sinara-hw/BaseMod/README.md

# BaseMod
Sayma RTM basic AFE module with RF output

## Design Files

Design files (schematics, PCB layouts, BOMs) can be found at [BaseMod/Releases](https://github.com/sinara-hw/BaseMod/releases).

## Wiki

More information can be found on the [wiki](https://github.com/sinara-hw/BaseMod/wiki).
