sinara-hw/BaseMod/(list of files, drawings)

Other design files:
ADC_4CH.SchDoc
BaseMod.PrjPCB
BaseMod.SchDoc
DAC_channel.SchDoc
Input_channel.SchDoc
Mgmt.SchDoc
PowerSupply.SchDoc
SEAx_connector.SchDoc
