sinara-hw/BaseMod/(threads)

Thread 1 (2018-08-18):

baseMod documentation

gkasprow, 2018-08-18:
_From @jbqubit on January 26, 2018 20:9_

baseMod is the-board-formerly-known-as-Allaki.

### AFE Interface

Discuss broader AFE interface concept. baseMod is one manifestation of an analog front end.

### baseMod details
[Wiki](https://github.com/m-labs/sinara/wiki/SaymaAFE) gives a head start.
- [ ] discussion of use case (frequency range, output impedance, etc)
- [ ] AFE interface (photo, names of pins)
- [ ] power dissipated

### test results
- [ ] output chain phase noise
- [ ] switch isolation
- [ ] attenuator isolation
- [ ] power supply rejection
- [ ] AM noise
- [ ] switch settling time
- [ ] attenuator settling time
- frequency-dependent plots (10MHz - 4GHz)
    - [ ] output chain S parameters vs frequency
    - [ ] cross-talk vs frequency
    - [ ] IIP3 vs power and frequency (2D)

_Copied from original issue: sinara-hw/sinara#491_

gkasprow, 2018-08-18:
_From @jbqubit on February 7, 2018 5:1_

@filipswit can @sbouhabib help you with this section of documentation?

gkasprow, 2018-08-18:
_From @filipswit on February 8, 2018 22:15_

Yes sure, that would be great.

gkasprow, 2018-08-18:
_From @jbqubit on February 14, 2018 23:57_

@sbouhabib @gkasprow @filipswit any word on this?

Thread 2 (2018-08-18):

BaseMod remove power detector in next revision?

gkasprow, 2018-08-18:
_From @jbqubit on December 4, 2017 21:26_

- [ ] Consider removing power detector from Allaki

Context:
- Usefulness of power detector is unclear:
  - It only connects to 24-bit ADC, which is very slow and software/gateware support not funded yet.
  - Gain flatness of Sayma/BaseMod should be fairly good compared with the amplifiers, filters etc that are used after it. Thus one generally wants to do power-levelling at the point of load, not at Sayma RF connector
  - BaseMod will have a low-noise MSPS ADC with programmable-gain front-end. Users can place a small power detector near their load. e.g. ADL5511. This will allow closed-loop feedback to the RF at the point where the user cares. Moreover, thermal environment of external power detector can be better controlled, allowing improved stability. External power detector can potentially also be used for using feedback to remove thermal transients in amplifiers etc.
- Power detector is the biggest component on BaseMod. BaseMod is very cramped, removing this will help quite a bit. It also reduces the amount of software support needed for BaseMod (and the number of things that need production testing).

Risk:
- Low, just remove a component!

---

Moving from https://github.com/m-labs/sinara/issues/269.

@hartytp asks
> Does anyone object to removing the power detector from BaseMod v1.1? cf #397

@dhslichter responds
> The point of the power detector is to noise-eat at the output of the DACs. What is it costing us?

@hartytp responds

Yes, but only when the switch is off, and only via the 24-bit ADC.

Main cost is space: as @sbouhabib pointed out elsewhere, this is the largest component on BaseMod and fitting it on was actually quite challenging. If we remove it then we can make the layout a bit less tight.

Not a huge deal, but it's not totally cost free so unless you really plan to use it then we should scrap it.
-----------------

My comments....

Agreed that space occupied by the power detector design is huge. Especially because it involves impedance controlled traces. Design complexity due to the inclusion of the detector can only be described as very high.

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

It also consists of 27 BOM items. AD8363 is about $7/ea and HMC349 switch is about $5. Component cost is not high.

> I don't think it's actually that useful because:
> It is read out by the 24-bit ADC which is very slow

The original intent to compensate for long-term drift. Not for fast feedback. As you point out the power can only be monitored when the RF output to the physics target is off (using HMC349 switch). This was never intended for fast feedback.

Agreed that this is something that probably should have been culled from the original design.

_Copied from original issue: sinara-hw/sinara#411_

gkasprow, 2018-08-18:
_From @hartytp on December 4, 2017 21:27_

So, are we happy removing it then? Is that a decision or a discussion?

gkasprow, 2018-08-18:
_From @jbqubit on December 4, 2017 21:29_

@hartytp No. This is not a decision. This is moving the discussion to a separate thread for discussion.

gkasprow, 2018-08-18:
_From @hartytp on December 4, 2017 21:31_

optimistic ;)

gkasprow, 2018-08-18:
_From @jbqubit on December 4, 2017 21:31_

Let's add to errata list #269 only once a decision is made.

gkasprow, 2018-08-18:
_From @hartytp on December 4, 2017 21:32_

ack

gkasprow, 2018-08-18:
_From @dhslichter on December 4, 2017 21:34_

I don't love it enough to fight for it.

gkasprow, 2018-08-18:
_From @hartytp on December 4, 2017 21:36_

> I don't love it enough to fight for it.

IME, that's generally a good indication that it's not useful enough to be worth keeping. I'll keep the pistols ready in case you change your mind though ;)

gkasprow, 2018-08-18:
_From @dhslichter on December 4, 2017 21:38_

I think my rationale is that probably I will be rolling my own special-purpose AFEs for the applications we want to be ultra-precise on and so we can always go back to this if we want to use it for design ideas later.

gkasprow, 2018-08-18:
_From @hartytp on December 4, 2017 21:40_

Sounds good. Let's get a stripped down basic AFE that works really nicely. People can then add their own pet features to it as they desire.

gkasprow, 2018-08-18:
_From @dtcallcock on December 4, 2017 21:41_

The two large red areas @jbqubit highlights on the left of the top image are the rf switches.  These would presumably be retained even if the detector was removed.

I like the power detector because I spend a lot of time in the lab plugging in the rf power meter to debug DDSs or calibrate out changes in output power vs frequency.  The latter is probably not that important for driving AOMs but will make the board much nicer for broadband applications.

gkasprow, 2018-08-18:
_From @hartytp on December 4, 2017 21:43_

But, won't you still end up doing that even with the power detector, since you can only calibrate up to the switch? The gain flatness of this board should be really quite good, so the amplifiers/filters you put after it will ultimately limit the gain flatness as much as the stuff up to the switch.

gkasprow, 2018-08-18:
_From @hartytp on December 4, 2017 21:44_

Anyway, you have an analog input, so your best bet AFAICT is to just add a small power detector + pickoff near your load. Then everything is calibrated. Plus, if you do it that way you get to use the nice 5MSPS ADC on the mezzanine so you can do it in-loop...

Edit: we have some thumb nail sized ADL5511 boards that are good to a few GHz, which are perfect for this kind of thing.

gkasprow, 2018-08-18:
_From @dtcallcock on December 4, 2017 21:54_

> But, won't you still end up doing that even with the power detector, since you can only calibrate up to the switch?

I think having signal sources that output the programmed power regardless of frequency is generally considered a useful thing regardless of the fact that amps aren't perfect.

> The gain flatness of this board should be really quite good.

I imagine the DAC output power is the main issue, especially as you start climbing up towards f_clk/2.

> Anyway, you have an analog input, so your best bet AFAICT is to just add a small power detector + pickoff near your load.

Given this is an option I don't think it's a big real to remove it.  I just like the option of doing this without adding over a dozen little minicircuits boxes and cables to the Sayma card...

gkasprow, 2018-08-18:
_From @hartytp on December 4, 2017 21:56_

Well, I think we've heard all possible arguments from each side. Time for a decision. How do we make those  in this project again (do I need to get my CAPSLOCK key out after all)?

gkasprow, 2018-08-18:
_From @hartytp on December 4, 2017 22:56_

I've added the "discussion" label to all Sayma and BaseMod issues that might be contentious. For most of these, the various possibilities have been mapped out, as well as the various arguments for and against each. So, now we just need an executive decision to be made. @jbqubit I assume that you will do that? If so, when you get a chance can you review them, make a decision, summarize the action points at the top of the issue, and remove the discussion label? Feel free to delegate some of this work if you'd rather.

gkasprow, 2018-12-15:
We will need some extra space to implement Sampler AFE + ADC, moreover we do not have any ADCs on Sayma.
I can try to fit all stuff and use remaining 4 channels of LTC ADC for power detector readout.

gkasprow, 2018-12-15:
We have much more space than in rev1. I can fit all we need easily

gkasprow, 2018-12-16:
we will make it
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

gkasprow, 2018-12-16:
@hartytp The AD8363 has power output and temperature output .
We can connect only PD outputs to four free channels of 8-channel LTC2320. It need dedicated drivers.
We can also use 4-channel LTC2324 and additional 8 channel sigma-delta ADC like was used on Sayma.

gkasprow, 2018-12-16:
@hartytp @jbqubit Here is _very_ initial version of board schematics and placement.
Still many things to do, but please have a look at it.
[BaseMod_FMC.PDF](https://github.com/sinara-hw/BaseMod/files/2683179/BaseMod_FMC.PDF)
Missing power budget, not verified logic levels, missing power sequencing analysis, PD outputs not assigned to ADC due to issue above.

hartytp, 2018-12-17:
I'd still really prefer to scrap the power detector since, for the reasons I've outlined before, I really don't think it's very useful: the power v frequency flatness of the DAC + AFE should be pretty good. RF from Sayma is almost never directly applied to an ion. Instead, it always goes via an amplifier and often an AOM. Those other components tend to limit the output power flatness, so there is not much point doing an open-loop calibration on the AFE mezzanine. Instead, it's much better to use the ADCs to do closed-loop feedback (which is what they're there for). Beyond that, if you just want to sanity check the RF levels you're applying to an amplifier then you can use Booster, which has good diagnostics.

IIRC @jbqubit has already made an executive decision to remove these power detectors from this design revision.

> We can connect only PD outputs to four free channels of 8-channel LTC2320. It need dedicated drivers.

No, let's not do that. I don't want to waste board space and money on drivers for these power detectors.

I also do not want to use the LTC2320, but rather the LTC2324-16, as it's faster. I also do not want to mix up these power detectors with the AFE analog inputs.

hartytp, 2018-12-17:
> @hartytp @jbqubit Here is very initial version of board schematics and placement.

Thanks @gkasprow! Still some work to do, but it looks really good as a starting point.

Shall we finalize the RTM first and then come back to this? At the very least, I'd like to know how much AMC <-> RTM IO we have before choosing ADCs etc

gkasprow, 2018-12-17:
OK, if we remove the power detector, routing of DAC signals would be far easier

hartytp, 2018-12-17:
> OK, if we remove the power detector, routing of DAC signals would be far easier

Good. Let's prioritise the core functionality of this design and make sure we leave enough room for a good, low cross-talk layout.

gkasprow, 2018-12-17:
OK, removed.

Closed 2018-12-17.

Thread 3 (2018-08-18):

BaseMod input path

gkasprow, 2018-08-18:
_From @hartytp on December 4, 2017 19:26_

- [x]  BaseMod input path should be a direct copy of Sampler.
- [x]  AFAICT, once we do this we can remove the -5V regulator.
- [x] If ADC on BaseMod is faster than 1 MSPS then change RC filter to increase BW appropriately.
- [x] Remove the "fast" input path where the SMA connects directly to the ADC driver OpAmp. This is no longer useful in the BaseMod design, as there won't be a fast ADC! This is easy to add back later if needed (i.e. if the JSED ADC is ever populated and supported!), but will simplify the routing/schematic for BaseMod.
  - [x] This means removing the solder jumpers. We can also remove the matching pads at the input (this signal BW is about 1MHz so we don't need to worry about matching connector parasitics out).

Risks:
- Low, we can copy an existing, well-tested design taken from Sampler.

_Copied from original issue: sinara-hw/sinara#409_

gkasprow, 2018-08-18:
The capacitors should be not far from the ADC, trace inductance can add some error. But they also shape the bandwidth so it may limit some use cases.

gkasprow, 2018-08-18:
_From @hartytp on December 4, 2017 20:0_

> But they also shape the bandwidth so it may limit some use cases.

True. But in this case, the capacitors are big enough and the frequency is low enough that I don't think it will be a problem.

gkasprow, 2018-08-18:
_From @hartytp on December 4, 2017 20:2_

I was thinking of the following layout for the ADC inputs on Sayma:
- 25R resistor
- Protection diodes (to +5V and GND)
- 25R resistor
- Capacitors

My reasoning is:
- I don't think it's going to be easy to sort the power sequencing out properly for these ADCs, so probably better to assume that the wrong voltages will be applied to the ADC inputs and make the whole thing robust with diodes.
- The idea of splitting the resistors is that the first resistor limits the current through the diodes, while the second resistor helps to ensure that the diodes turn on before the diodes in the ADC (what do you think about this approach).

Since there is no resistor on the AFE, the OpAmps will see the capacitive load presented by the traces and connectors. Do you think this will be enough to cause ringing? If so, should we put something like 20R on the AFE right by the OpAmp outputs?

gkasprow, 2018-08-18:
@hartytp this approach should work.

gkasprow, 2019-04-16:
not relevant anymore

Closed 2019-04-16.

Thread 4 (2018-08-18):

BaseMod RF connectors

gkasprow, 2018-08-18:
_From @hartytp on December 1, 2017 16:15_

- [ ] Replace SMA connectors on BaseMod used for analog inputs with MMCX (lave RF outputs alone)
- [ ] Should ship short (say, 10cm) MMCX to SMA pigtails for convenience

Context:
- Not enough space on front panel for SMAs for outputs and inputs
- High density RF connectors don't really make sense, since: the load almost always has an SMA on it, so breakout is always needed; they're either very expensive, or have surprisingly poor RF performance; they're not trivial to get hold of.
- Given the low frequency of the inputs compared with the outputs, it makes most sense to replace the input connectors with a smaller, cheaper lower-frequency connector and leave the outputs as SMA
- MMCX is relatively standard and easy to get hold of and very cheap.

_Copied from original issue: sinara-hw/sinara#402_

gkasprow, 2018-08-18:
What about SMB connectors? They can be densely packed.

gkasprow, 2018-08-18:
_From @dtcallcock on December 1, 2017 18:58_

If we switch the ADC inputs to a small flush-mounting connector like MMCX there will presumably be enough room for SMAs.

I want to use this board to generate 1.7GHz with good long term channel-channel phase stability.  Therefore I would like a connector that doesn't rotate or 'float'.

Will also prevent accidentally mixing up inputs/output.  Something that'll be easy to do on a cramped panel.

gkasprow, 2018-08-18:
_From @dhslichter on December 1, 2017 19:17_

SMA for DAC outputs, MMCX for ADC inputs (only using 1 MSPS ADCs on the BaseMod board) sounds like a good plan to me.  Will they fit @gkasprow?

gkasprow, 2018-08-18:
@dhslichter MMCX connectors are much smaller so they will fit easily. Moreover they don't need any additional space for a wrench so once you unplug them, access to SMAs will be far easier.

gkasprow, 2018-08-18:
I just got replay from Samtec:
> I’m sorry for my delayed response.
> There are no plans to release the -03.0 lead style for our IsoRate product line.
> The NRE for tooling would be greater than $50K.

It seems there is no way to use these connectors.
But we use FMC modules with same AMC front panels and it fits. The stacking height is 10mm. The only difference is that surface mounted SMA connectors cannot be used. Right angled versions fit well.
So if we adopt FMC or PMC (slightly wider) front panels idea we could use these Samtec connectors as well.

gkasprow, 2018-08-18:
_From @dhslichter on December 8, 2017 16:38_

Ouch!  That's not what you like to hear from Samtec...

IIRC once of the issues was component height on the bottom side of the BaseMod board, which restricted the stack height of the RTM/AFE connectors.  Can we get away with 1 mm less clearance on the bottom side?

gkasprow, 2018-08-18:
_From @hartytp on December 8, 2017 17:20_

> But we use FMC modules with same AMC front panels and it fits. The stacking height is 10mm. The only difference is that surface mounted SMA connectors cannot be used. Right angled versions fit well.
So if we adopt FMC or PMC (slightly wider) front panels idea we could use these Samtec connectors as well.

So, to check I understand you:
- The current stacking height on the AFE mezzanines is 9mm
- 9mm stacking RF connectors aren't available from Samtec
- 10mm are connectors readily available
- 10mm is a nice standard height anyway -- e.g. it's used by FMC

As @dhslichter says, the only potential issue I see with the 10mm height is that it gives us less room on the side of the AFE mezzanines opposite the connectors. This is the side with the input components on. AFAICT, these are all low profile components (with the possible exception of the CMCs, but those are low priority components which can easily be scrapped) apart from the SMAs. So, as long as you can find decently priced SMAs that fit, I'd say let's go for the 10mm stackup.

gkasprow, 2018-08-18:
@hartytp standard, low cost right-angled SMAs work just fine.
But their matching is far worse then SMT ones we use right now.
[This](https://www.ohwr.org/projects/fmc-adc-130m-16b-4cha/wiki/wiki) is example of a card I designed some time ago.
At that time I used SMT SMA connectors, but they are too fragile so were replaced by THT version.
[There](https://www.ohwr.org/attachments/3388/bot_r.jpg) is a place on the bottom side of the board. 2mm components fit easily

gkasprow, 2018-08-18:
_From @hartytp on December 8, 2017 18:20_

> @hartytp standard, low cost right-angled SMAs work just fine.
But their matching is far worse then SMT ones we use right now.

Anyway, this isn't a problem, as we've already decided to replace those SMA connectors with MMCX, (the bottom-side connectors are the input ones)?

Even with the JSED ADCs, this is only a 100MHz input, so cheaper SMAs should be fine here if one really wants to go that way. Or, SMPS would fit as well.

So, my vote is to go for the 10mm stackup. It's more standard than 9mm which is nice, and it leaves more room for screening on the critical RF parts on the top side of the board.

gkasprow, 2018-08-18:
_From @hartytp on December 8, 2017 18:21_

Unless there are any objections to the 10mm stackup, I'll update the issue summary to reflect this decision.

gkasprow, 2018-08-18:
_From @dhslichter on December 8, 2017 19:23_

> @hartytp standard, low cost right-angled SMAs work just fine.
But their matching is far worse then SMT ones we use right now.

I think the point is that with a 10 mm stackup, we have to use these angled SMAs for the DAC outputs -- cannot use the current surface-mount/cutout SMAs for the DAC outputs.  And since we care about the connector performance, this is less desirable, especially if we'd like to use the same kind of component on MixMod.

@gkasprow how about something like https://www.digikey.com/product-detail/en/cinch-connectivity-solutions-johnson/142-0771-831/J808-ND/726115 or https://www.digikey.com/product-detail/en/cinch-connectivity-solutions-johnson/142-0761-801/J797-ND/726105?  This would stick out another 3 mm past the RTM-facing surface of the mezzanine card, thus a total of 10 mm (stackup) + 3 mm + 0.8 mm (half of RTM thickness) is 13.8 mm from the RTM centerline.  According to the spec it looks like we can do this mechanically if we are prepared to notch the faceplate in the areas where mezzanine cards would come through.  This is probably very nice to do anyway to help with ease of installation.

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

gkasprow, 2018-08-18:
@dhslichter we use this kind of SMA connector already on the RTM board.
Anyway, almost all SMA THT connectors have same position of the hot signal pin with respect to the PCB surface. Good matching is achieved when one does not bend the signal path. Main difference is how they are fixed to the PCB edge.
Maybe there are some high performance RA SMT or THT SMA connectors?
What about [this](https://www.pasternack.com/sma-female-standard-thru-hole-pcb-connector-pe4545-p.aspx)?  Would such performance be OK?

gkasprow, 2018-08-18:
_From @dhslichter on December 8, 2017 19:50_

@gkasprow are the dimensions/plan I outlined above not workable?  The connectors you mention could potentially work, but they are considerably more expensive (~$18/channel more than the regular edge mount SMA) and they probably won't have as good performance -- although they are spec'ed up to 12.4 GHz.

gkasprow, 2018-08-18:
@dhslichter let me do some quick simulation. It will be hard to install insulation washers due to the AMC edge.
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

gkasprow, 2018-08-18:
And we need bulkhead connector to attach them to the front panel.

gkasprow, 2018-08-18:
_From @dhslichter on December 8, 2017 20:22_

Another consideration: if instead of using Samtec RF connectors plus a separate pin header, we went to a single connector per mezzanine using some high-speed connector?  If we used an FMC connector with 7 mm stackup, the test reports can be found here:
http://suddendocs.samtec.com/testreports/hsc-report-seam-seaf-07mm_web.pdf
http://suddendocs.samtec.com/testreports/hsc-report-sma_seamp-seaf-07mm_web.pdf

We'd be running the DAC signals as differential, could surround them with ground pins, and you can then achieve very low crosstalk (70-80 dB below 1 GHz even for nearby pairs, could isolate more since there are so many pins you can move the other signals farther away).  This connector has enough pins to send in all 4 DAC signals as differential pairs, plus a bunch of nice differential pairs for LVDS signaling from an ADC, plus lots of leftover pins for power, slow single-ended logic, etc.  We would just need to take care to place these other pins physically farther away, and ground the various intervening pins to create an effective crosstalk shield around the DAC traces.

If you go this way, though, you have a single connector to attach the AFE to the RTM board.  Then you can make the stackup 7 mm or 8 mm instead of 10 mm and all these issues with the SMA are resolved as well.

This would be ~$35 for both connectors (AFE plus RTM), plus it lets us use cheaper and higher performance SMA connectors for the front panel, and have them better centered in the RTM front panel as well.

gkasprow, 2018-08-18:
_From @dhslichter on December 8, 2017 20:23_

> And we need bulkhead connector to attach them to the front panel.

@gkasprow I was envisioning that the front panel would be held on to the board by other means (screwed in to a little right-angle block, perhaps), and that you'd just use something fairly thin.  Then you just poke the SMA through the middle of the front panel but it doesn't touch or have mechanical attachment to the fron panel.  The entire front panel is a small part that then contacts the RTM front panel with an EMI gasket around the edges.  No need for insulating washers then as the SMA outer shield is not touching the front panel.

gkasprow, 2018-08-18:
@dhslichter I remember our discussion a year ago and this type of connector was disqualified. Maybe it was done too early. We don't need FMC connector but smaller one from Searay family.

It would be nice to reuse standard PMC front panels which are slightly more wide than FMC.

gkasprow, 2018-08-18:
@dhslichter I saw today that our RF guys are using FMC connectors for real RF stuff. I just saw some random PCB, need to ask for details. Maybe @sbouhabib knows more details..

gkasprow, 2018-08-18:
_From @dhslichter on December 8, 2017 20:28_

> @dhslichter I remember our discussion a year ago and this type of connector was disqualified. Maybe it was done too early. We don't need FMC connector but smaller from Searay family.

I remember that too -- I think the issues were that we wanted crosstalk as low as possible, and to have the AFE boards be simple/user-solderable (which SEARAY is not really).  I think that given our other options we are debating, the crosstalk is in the same ballpark.  The user-solderable AFE was a nice idea but SEARAY is easy to have a boardhouse assemble for you reliably, so I don't think it's a big issue.

gkasprow, 2018-08-18:
_From @dhslichter on December 8, 2017 20:29_

> @dhslichter I saw today that our RF guys are using FMC connectors for real RF stuff. I just saw some random PCB, need to ask for details. Maybe @sbouhabib know more details..

That would be awesome, I am sure they will have some useful opinions.  We only need to have signals running through up to ~3.5 GHz at the absolute maximum.

gkasprow, 2018-08-18:
_From @hartytp on December 8, 2017 20:30_

I'd still be a bit worried putting about putting the LVDS bus and DAC signals on the same connector. Might be fine depending on how they are distributed in the connector. Would probably need some data/prototyping in any case. But, yes, would be really interested to hear from @sbouhabib about this.

gkasprow, 2018-08-18:
_From @hartytp on December 8, 2017 20:33_

> I think the point is that with a 10 mm stackup, we have to use these angled SMAs for the DAC outputs -- cannot use the current surface-mount/cutout SMAs for the DAC outputs. And since we care about the connector performance, this is less desirable, especially if we'd like to use the same kind of component on MixMod.

Use SMPs on MixMod?

gkasprow, 2018-08-18:
_From @hartytp on December 8, 2017 20:37_

> We'd be running the DAC signals as differential, could surround them with ground pins, and you can then achieve very low crosstalk (70-80 dB below 1 GHz even for nearby pairs, could isolate more since there are so many pins you can move the other signals farther away). This connector has enough pins to send in all 4 DAC signals as differential pairs, plus a bunch of nice differential pairs for LVDS signaling from an ADC, plus lots of leftover pins for power, slow single-ended logic, etc. We would just need to take care to place these other pins physically farther away, and ground the various intervening pins to create an effective crosstalk shield around the DAC traces.

> If you go this way, though, you have a single connector to attach the AFE to the RTM board. Then you can make the stackup 7 mm or 8 mm instead of 10 mm and all these issues with the SMA are resolved as well.

This does sound quite appealing on many fronts: cost, insertion force, availability of components, etc. And, you're right, we can add a lot of ground pins to really stamp out the cross-talk. The test PCB you'd need to characterize this would be pretty trivial to make -- an FMC and a few SMAs.

gkasprow, 2018-08-18:
_From @dhslichter on December 8, 2017 20:45_

The standard FMC connectors would be nice @gkasprow from an availability standpoint.  We can do an 8.5 mm stackup, which fixes the SMA issue on the front panel.

However, I can see value in choosing a connector which does not intermate with FMC, though (e.g. slightly fewer pins) so that people don't try to mate with an FMC (potentially blowing it up in the process).

gkasprow, 2018-08-18:
It's enough to change the gender of connectors.
Would there be any benefit to adopt FMC mechanical form factor? PMC would be too wide, but FMC should be fine both in terms of panel size. Board would be same length as current mezzanine is.
One can  fit there 4 SMAs and 4 MMCXs

gkasprow, 2018-08-18:
FMC panel requires 10mm distance, anyway, we can go for something similar. The advantage of FMC mechanical fixing is its rigidity.

gkasprow, 2018-08-18:
_From @hartytp on December 8, 2017 22:41_

@gkasprow Sticking to something as close to FMC sounds good to me.

How does the width of FMC compare to 2x the width of the current Allaki/BaseMod?

gkasprow, 2018-08-18:
_From @hartytp on December 8, 2017 22:42_

So long as the cross-talk/RF performance is good enough, adopting an FMC form factor and mounting sounds like a really good idea IMO.

gkasprow, 2018-08-18:
@hartytp the FMC connector will fit easily. FMC is 2 mm narrower than doubled Allaki/BaseMod.
Anyway we cannot use FMC connector as it is, so will have dedicated version machined  that is perfectly adopted to what we need.

gkasprow, 2018-08-18:
_From @hartytp on December 9, 2017 0:22_

> @hartytp the FMC connector will fit easily. FMC is 2 mm narrower than doubled Allaki/BaseMod.

Sorry, I meant how does the width of a FMC card (not connector) compare with a doubled Allaki/Base mod? Sounds like a FMC card is almost exactly the right size for us, which is good!

> Anyway we cannot use FMC connector as it is, so will have dedicated version machined that is perfectly adopted to what we need.

Not sure I follow you here. Do you mean having a custom FMC connector made? Or, do you mean having a PCB made that has a slightly different shape to a standard FMC card?

gkasprow, 2018-08-18:
_From @hartytp on December 9, 2017 0:29_

@gkasprow Are you okay to make a simple test PCB to see if the FMC or similar connector will work for us?

- [ ] Choose a sensible pin assignment for this, including
  - 4 differential DAC channels
  - 4 differential JSED ADC channels
  - LVDS bus for AFE ADC
  - Power, ground
  - The misc digital lines we have on the current AFE (SPI for attenuators, TTL for switches, I2C, etc)
  - Make sure connector pinout is designed for minimum cross-talk. e.g. space LVDS far from DAC and surround each DAC with as many grounds as possible.
  - How do you make FMC 50Ohm? If you surround the DAC channels by ground, does that create a 50Ohm transmission line?
- [ ] Make simple test PCB with our chosen connector (e.g. FMC) and SMAs for the DAC/ADC/LVDS lines. Then we can measure insertion loss/return loss/cross-talk between all channels.

With that information, we can decide if this is good enough.

gkasprow, 2018-08-18:
_From @dhslichter on December 11, 2017 18:51_

@gkasprow @hartytp I think we should use a connector pair from the SEAM/SEAF series, but not with the same pin count as FMC, so that people do not mistakenly populate a Sayma AFE into a FMC slot or vice versa.

gkasprow, 2018-08-18:
_From @hartytp on December 11, 2017 18:56_

@dhslichter Sure, anything like that is fine by me.

I'd love it if these connectors worked out, since they'd be great from a mechanics, cost and availability stand point.

FWIW though, I'm still not convinced by the RF performance of those connectors. The data on the links you sent didn't look great. e.g. cross-talk was -30dBc at 12GHz, so (do we assume 20dB/dec?) something like -50dBc at 1GHz. We'd probably want more than 80dBc at 1GHz, and it's not clear to me that spacing the pins we use out a bit more + adding some more ground will really do that. Simillaryly, the impedance control looked a bit poor.

Still, will be interested to hear from @sbouhabib or to see some measurement results.

gkasprow, 2018-08-18:
_From @dhslichter on December 11, 2017 21:4_

>  The data on the links you sent didn't look great. e.g. cross-talk was -30dBc at 12GHz, so (do we assume 20dB/dec?) something like -50dBc at 1GHz. We'd probably want more than 80dBc at 1GHz,

Just look at the plots here rather than extrapolating.  We are more concerned with FEXT than NEXT because the outputs of the DAC should be reasonably well matched and able to handle low-level interference.

>  it's not clear to me that spacing the pins we use out a bit more + adding some more ground will really do that.

Again, below shows how things have worked with several different combinations of pin pairs, so you can see that ground/distance is not everything, but there are some combinations that work better than others.  Making a test board would be the thing to do.

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

>  Simillaryly, the impedance control looked a bit poor.

If you're trying to send random digital signals at 12 GHz, sure.  However, we're talking about signals at max 3.5 GHz, with slow envelopes on them (tens of ns timescales at the very fastest).  I'd argue here that the connector return loss is a relevant spec here as well as impulse responses.  Your point is taken, but if you see how this stacks up against the IJ5/IP5 we are considering as the alternative, it all looks pretty similar: http://suddendocs.samtec.com/testreports/hsc-report_ij5-ip5_web.pdf .  The crosstalk is a bit better with IJ5/IP5 but the return loss is same/worse and the impulse response is similar.

In the end, if "cheapo" performance won't cut it, we're stuck with SMP.  Furthermore, if we do end up going with IJ5/IP5, we have to use right-angle SMA connectors at the panel and those definitely have worse impedance properties, so you have to choose your poison a bit.

If there's a better solution addressing the combined problems of high RF performance requirements, lower stack heights, lower cost, avoiding the use of multiple RTM-AFE connectors per AFE board, etc, I am happy to entertain it -- it just seems right now that it's hard to have everything be perfect.

gkasprow, 2018-08-18:
@hartytp Let's talk about FMC connector testing. To make it happen and test with SMAs one need to add some form of matching. I'm not sure what impedance such FMC has. Is it 50Ohm or let's say 60Ohm and it is optimised for diff operation where 2x60 Ohm gives 100Ohm.
What exact scenarios do you want to test?
I can use low cost FR4 prototyping service where boards are printed using shared documentation.
@dhslichter I'd like to use identical connectors as used for FMC but reverse the gender. I'm pretty sure that no one will try to plug Sayma AMC to Sayma RTM then :)
If we want to connect all lines to the SMAs, there are plenty of them.
So I will take 400pin connector, one side will reserve for LVCMOS and LVDS signals, then array of GNDs, later on DAC , array of GNDs, and  JESD pins.
Who wants to measure it?

gkasprow, 2018-08-18:
_From @dhslichter on December 11, 2017 21:38_

> @dhslichter I'd like to use identical connectors as used for FMC but reverse the gender. I'm pretty sure that no one will try to plug Sayma AMC to Sayma RTM then :)

Sounds good to me!

> Who wants to measure it?

Probably we'd need to look over some schematics first :)  Manufacture with the same stackup (at least for the top layer thickness) as the RTM card.  Would need to have some baluns on the board to convert between differential and single-ended (network analyzer excitation will be single-ended).  Looking at the Samtec test board layout/design might inform some of this.

gkasprow, 2018-08-18:
_From @hartytp on December 12, 2017 1:18_

@dhslichter Okay, looking at that data more closely, I agree it looks pretty good in terms of RL and Xtalk for the differential lines.

One thing that wasn't clear to me: what are all the pins labelled T in the test setup? 50R terminated? Or just grounded.

> I'm not sure what impedance such FMC has. Is it 50Ohm or let's say 60Ohm and it is optimised for diff operation where 2x60 Ohm gives 100Ohm.
What exact scenarios do you want to test?

From the plots in the link @dhslichter shared, it looks like a pair of adjacent pins (either horizontal or vertical) surrounded by ground should give a good 100Ohm transmission line. So, matching from a 50Ohm feed in just needs a 2:1 balun. Say TCM2-43X+.

> I can use low cost FR4 prototyping service where boards are printed using shared documentation.

Worth going to FR408 or similar to have good controlled impedance traces? Also, not to self, let's have a calibration signal on the PCB as well (SMA, trace, balun, trace, balun, trace, SMA) for good measure.

> So I will take 400pin connector, one side will reserve for LVCMOS and LVDS signals, then array of GNDs, later on DAC , array of GNDs, and JESD pins.

Sounds good. although what do you mean by "JSED pins"?
- Make sure to space the DAC and ADC lines out with as much ground as possible.
- The plots in the files that @dhslichter uploaded suggest that diagonal spacings work best (see the difference between teh 136/126 and 117/107 cross-talk figures)
- Not sure if it will help to alternate "horizontal" and "vertical" routing stratergies?

As @dhslichter Says, I think the first thing to do is to is to propose a pinout for the connector.

> Who wants to measure it?

If you design the board, I'm happy to do the tests.

---

Before we go too far down this line, it would be good to hear from Sammer on things like:
- Have they routed high-frequency analog signals on FMCs before?
- If so, how well did it work?
- Do they have any advice for how to do this? (e.g. how to space pins out to minimize cross talk)
- Is FMC the best connector to use for this, or is there a similar one they've found to work better?

gkasprow, 2018-08-18:
_From @hartytp on December 12, 2017 3:29_

> Not sure if it will help to alternate "horizontal" and "vertical" routing stratergies?

Anyway, it probably makes sense to try out a few different strategies for distributing/orienting the signal pairs on the test PCB so we can test things like this out.

FWIW though, given how many other things are going on at the moment, making this test PCB should not be top priority right now!

Closed 2018-12-15.

Thread 5 (2018-08-18):

Sayma AFE cost

gkasprow, 2018-08-18:
_From @hartytp on November 29, 2017 18:36_

- [ ] Review factors that contribute to the cost of Sayma AFE mezzanines and see if we can adjust the design to minimise costs.

- Current BaseMod AFE design costs 500EUR per AFE/2k EUR per Sayma! That's very significant (price will be a key factor in determining user adoption of Sayma compared with competing systems).
-  For Sayma v2.0 I'd really like to get to the point where separating the AFE onto a separate mezzanine does not contribute significantly to the overall cost of Sayma, compared with putting the AFE directly on the Sayma PCB.

Thoughts for cost reduction:
  - BaseMod can be FR408 (or even FR4?) rather than fancy Rodgers material (RF trace widths will need a tweak). Only top-layer needs to be good RF substrate, rest can be FR4 to cut costs.
- Swapping mezzanines from 2 DAC channels each to 4 channels each will help reduce mezzanine cost (and improve mechanics etc as well)
- Using multi-pin Samtec RF connectors will make a huge difference on cost of Sayma. Currently Sayma has

_Copied from original issue: sinara-hw/sinara#387_

gkasprow, 2018-08-18:
It is roughly 500EUR @ 25pcs.
The most expensive are SMA (TELEGARTNER) and SMP connectors.
Rogers material and process is also quite expensive. We can also use FR408, but here @sbouhabib opinion is needed.

gkasprow, 2018-08-18:
@hartytp regulator price is negligible.

gkasprow, 2018-08-18:
_From @hartytp on November 29, 2017 19:15_

Okay, that's a pretty high cost given how cheap the important components are.

More reason to replace the SMAs + SMPs with something cheaper and better mechanically.

I'd guess FR408 is absolutely fine for the relatively low frequencies we're working at (the trace length isn't that long IIRC). That should also reduce the lead time quite a bit, which is nice!

gkasprow, 2018-08-18:
_From @dhslichter on November 29, 2017 20:54_

For Allaki, I think FR408 is acceptable in terms of loss and impedance-matching quality because the frequencies involved are not aiming to be too high.  One reason we went for Rogers originally was that I had done a bunch of work with it already in testing trace widths etc., and we thought we'd try to put microwaves out directly with mix-mode (recall one can nominally generate 43Ca+ microwave frequencies using mix-mode...).  Let's save the fancy materials for another board.

gkasprow, 2018-08-18:
_From @jbqubit on November 30, 2017 21:21_

Cheaper, easier to manufacture sound like pluses. Specification of a thicker PCB would help with insertion force.

gkasprow, 2018-08-18:
_From @hartytp on November 30, 2017 21:25_

What's the insertion force of one of those 10-pin RF connectors? My guess is it's low enough that we don't need a thicker PCB (which is generally more expensive to manufacture, particularly when using nice laminates like FR408). But, Greg's test PCB will tell us this...

gkasprow, 2018-08-18:
_From @dhslichter on November 30, 2017 21:38_

You can probably make a top layer of FR408 with thicker layers of regular FR4 below (if we only care about the DAC side having good high-frequency loss properties).

gkasprow, 2018-08-18:
@dhslichter Yes, one can also combine FR4 with Rogers.

gkasprow, 2018-08-18:
_From @dhslichter on November 30, 2017 22:52_

Is that not what is being currently done for Allaki?

gkasprow, 2018-08-18:
_From @dhslichter on November 30, 2017 22:53_

Our NIST microwave boards are single layer Rogers on 3 layers of FR4 for cost purposes.

jbqubit, 2019-05-28:
@gkasprow Can probably close this.

Closed 2019-05-28.

Thread 6 (2018-08-18):

BaseMod rev1 errata

gkasprow, 2018-08-18:
_From @gkasprow on September 4, 2017 19:55_

- [x] replace AD8363ACPZ-WP  with AD8363ACPZ-R7CT-ND
- [x] replace ADT7420UCPZ-R2 with ADT7420UCPZ-RL7TR-ND
- [x] This board has a lot of pads for potential matching components. At the frequency this AFE is designed to operate at, these are unnecessary. Please remove them from the schematic + layout to simplify things and save space (the boards are quite cramped atm).
- [x] We do not need an input path that bypasses the InAmp. Please remove these solder jumpers.
- [x] Zero-index everything (silk, schematic, panel)
- [x] Make sure that we're using the cheapest acceptable substrates. e.g. FR408 on the RF layer, FR4 everywhere else.
- [x] Should we add inductors on the +-12V to filter them (these are generated by SMPSs on Sayma and do not have LDOs on BaseMod so may contain high-frequency noise).
- [x] Add version number to schematic
- [x] Text is upside down for C4, R40, R42, C63 (although, these are being dropped from V2.0)
- [x] should probably have a power budget on the schematic like the ones for the EEMs.
- [x] Input/output connector caps should be 2*1nF on each connector. (Why are there three caps on the input SMA?)
- [x] add current limiting resistor for attenuator output

_Copied from original issue: sinara-hw/sinara#269_

gkasprow, 2018-08-18:
_From @sbourdeauducq on September 5, 2017 3:19_

As explained in detail several times already, it would be better to have one issue for each item instead of one big errata, and use milestones and labels.

gkasprow, 2018-08-18:
_From @jbqubit on September 22, 2017 17:55_

@gkasprow asked in email
>To do tests of Allaki, I'd need sine wave at the DAC output. The sooner, the better.
What about clocking DAC from 100MHz source?

gkasprow, 2018-08-18:
_From @jbqubit on November 16, 2017 15:40_

- Allaki as-shipped to UMD do not have serial numbers. Please add serial numbers so end-users, WUT and Technosystem can track.

- back-side silkscreen double printing
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

- As-shipped to UMD insulating front-panel missing. @gkasprow is sending the right panel. Photo from @gkasprow below so everybody can see what this will look like.
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

marmeladapk, 2019-01-23:
> replace ADT7420UCPZ-R2 with ADT7420UCPZ-RL7TR-ND

Not changed in current schematics.

> This board has a lot of pads for potential matching components. At the frequency this AFE is designed to operate at, these are unnecessary. Please remove them from the schematic + layout to simplify things and save space

@hartytp @jbqubit Is this still relevant?

> FR408 on the RF layer, FR4 everywhere else.

FR4 is on all layers.

> inductors on the +-12V

Placed on RTM.

> Input/output connector caps should be 2*1nF on each connector

Now there are 2*10nF on inputs, + additional 10pF on output.

> add current limiting resistor for attenuator output

@hartytp @jbqubit Is this still smth to do, or are 0 Ohm resistors on output fine for this purpose?

Closed 2019-04-16.

Thread 7 (2018-11-28):

RF switches off by default

jbqubit, 2018-11-28:
RF switches pulled off by default. This prevents random output during power-on and while DACs are being configured. cf https://github.com/m-labs/artiq/issues/1031

gkasprow, 2018-12-15:
I swapped RF switch output so with low level of control signal, output is disabled.

Closed 2018-12-15.

Thread 8 (2018-12-17):

choice of ADC

hartytp, 2018-12-17:
Let's use LTC2324-16 for the BaseMod/MixMod AFE ADC.

If we have enough IO, I'd like to connect 6 diff pairs to the AMC FPGA: SDOA-SDOD, CLKIN, CLKOUT.

We could in principle save IO on the AMC<->RTM connector by:
- Operate in DDR mode and only use 2 data lanes (SDOA, SDOC)
- Put CLKIN generator on the RTM FPGA

hartytp, 2018-12-18:
It looks like we can spare 7 LVDS links between the AMC FPAG and each AFE mezzanine. If that's true, then we should consider using the [LTC2325-16](https://www.analog.com/en/products/ltc2325-16.html#product-overview) as our ADC. I believe this is pin compatible with the LTC2324-16 and a similar cost (this needs checking) but is capable of faster operation. The only downside is that it doesn't support the 2-lane operation that the LTC2324-16 does, but that's not an issue if we have IO to spare.

jbqubit, 2018-12-19:
LTC2325-16 looks good
- 4 channel
- 5 Msps per channel throughput
- one cycle latency
- 82 dB SNR at 2 MHz

@gkasprow Is there IO to spare for the LTC2325-16? If nobody has any objections let's lock this in @hartytp.

jbqubit, 2018-12-19:
What I mean is locking in RTM dependencies so @gkasprow has certainty about RTM schematic modifications.

gkasprow, 2018-12-19:
Yes, we have plenty of space.

jbqubit, 2018-12-19:
OK. Update https://github.com/sinara-hw/sinara/issues/605 and let's close this Issue unless something else comes up. :)

marmeladapk, 2019-01-23:
@gkasprow Currently in schematics there is LTC2324. @hartytp Should it be changed according to this thread?

gkasprow, 2019-01-23:
oh, it's missing -16 in the PN. I will fix it.

hartytp, 2019-03-26:
While I'd generally prefer the LTC2325-16 (5MSPS) it's availability seems pretty poor. So, unless someone knows of a reliable source of it, let's go for LTC2324-16 instead.

Closed 2019-04-16.

Thread 9 (2018-12-20):

fp connector

hartytp, 2018-12-20:
if were converging on MCX as our choice elsewhere then let's use that for the analog inputs, assuming there is enough space (we're currently using MMCX which is a little smaller and less robust).

marmeladapk, 2019-01-23:
@gkasprow Currently there are MMCX in schematics.

gkasprow, 2019-01-23:
True, I didn't implement all the fixes yet.

gkasprow, 2019-04-16:
no way to fit both SMA and MCX.

Closed 2019-04-16.

Thread 10 (2019-01-07):

BOM availability check

marmeladapk, 2019-01-07:
Low availability:

- 85_MMCX-50-0-1/111_OE (20 pcs in Mouser)

Not available:
- Everything from Mini Circuits (just to be noted here)
- AORN2-1AT3

gkasprow, 2019-05-20:
no longer an issue.

Closed 2019-05-20.

Thread 11 (2019-01-23):

Schematic cosmetics

marmeladapk, 2019-01-23:
- [x] On DAC_channel: dicrete-elemet -> discrete-element
- [x] J22, IC14, IC6 mark unconnected lines with NC

marmeladapk, 2019-01-23:
Power estimation:
 - [ ] IC24 (8 mA) could be added to 2V5
 - [ ] LTC2324 has 31,5 mA max on 2V5 and 36,5 mA max on 5V0
 - How was ERA-3XSM current counted?

gkasprow, 2019-05-20:
I added LVDS current to LTC2324.
ERA-4XSM+ current estimation was wrong. It should be 4x65mA

gkasprow, 2019-05-20:
Wrong PN for power amplifier was used.

Closed 2019-05-20.

Thread 14 (2019-03-09):

DAC output -> fast comparator -> RTM FPGA input

sbourdeauducq, 2019-03-09:
Is it realistic to add such a path on Sayma RTM?

* Useful as a built-in self-test to check that DAC outputs are toggling *and* synchronized to the FPGA.
* Useful as a back-up synchronization path if we can't get everything to respond properly to SYSREF (AMC FPGA would reorder samples based on what the actual DAC output is).
* One path for each DAC.
* AMC FPGA generates test pattern on JESD204 which is timed by DDMTD core on RTM FPGA.
* RF switch on AFE can be used to disable output during BIST.
* The fast comparator could potentially be a hacked LVDS input buffer in the FPGA, with proper signal conditioning.
* Maximum DAC frequency is 1.2GHz. Maximum data rate received correctly by the FPGA is rated at 1250MBps (625MHz). We can either add a RF switch to avoid overloading the FPGA input, or just hope that it won't cause any ill effects. Based on past experience with Sayma, I prefer the former option.
* If we use an external comparator, the RF switch action can be effected by driving the other comparator input out of DAC range.

gkasprow, 2019-04-16:
@hartytp @sbourdeauducq
We don't have any RTM LVDS lines anymore. But we still have 5 AMC LVDS pairs.
Shall I connect the comparator directly to the DAC output or after the attenuator or even power amplifier vis some attenuator?
Which comparator to use?
I use in other designs LMH7220 / ADCMP605 / ADCMP604 / LTC6754.
I will add a power switch to disable the comparators when not needed. Some of them have the disable input already.

sbourdeauducq, 2019-04-17:
>  We don't have any RTM LVDS lines anymore. But we still have 5 AMC LVDS pairs.

What are the various LVDS lines currently used for? Ultrascale tends to be a pain for timing-critical cores.

gkasprow, 2019-04-17:
they are used for LEDs and ADC gain control. I can replace them with US LVDS easily.
Here is a schematic of the comparator circuit.
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

sbourdeauducq, 2019-04-17:
Yes, maybe we can leave the LEDs to the Ultrascale...
What's the idea here exactly with some control signals going to the RTM FPGA and others to the AMC? How did you decide which lines go to which FPGA?

gkasprow, 2019-04-17:
we have:
- 12 LVDS AMC lines. they will go mostly to the ADC and LEDs
- 8 LVDS RTM lines. They will go to comparators and ADC gain setting
- 15 LVCMOS RTM lines - they are used for attenuator and RF switch control

gkasprow, 2019-05-20:
no comments so closing.

Closed 2019-05-20.

Thread 19 (2019-03-26):

do not daisy chain output attenuators

hartytp, 2019-03-26:
AFAICT we have enough IO to put each ADC gain and each DAC attenuator on a separate bus. This is vastly preferable since it means that we don't have issues where programming one attenuator reprograms all others (which is a PITA in the current Urukul implementation)

gkasprow, 2019-04-16:
dedicated serial inputs and outputs added, common clock and CS lines

Closed 2019-04-16.

Thread 20 (2019-03-26):

ground ouput connectors

hartytp, 2019-03-26:
but don't ground input connectors (we have an InAmp and protection diodes, so these should be fine)

Closed 2019-04-16.

Thread 24 (2019-03-26):

R36 power handling

hartytp, 2019-03-26:
@gkasprow in this version, we're still using the higher current pre-amplifiers (compared to the ones on Urukul).

The pre-amps on the current design then we need to watch the power handling on R36 (the amplifier bias resistor). At 65mA this dissipated 425mW. Can it handle that?

In the long run, it might be wise to consider either switching to the same lower current pre-amps we're using on Urukul or using a current source to bias the amps. (If I have time then I may test the later out using an eval board when Sayma v2.0 arrives)

hartytp, 2019-03-26:
Other than that, I don't see any issues with the current design.

gkasprow, 2019-04-16:
replaced with 1218  1W resistor

Closed 2019-04-16.

Thread 25 (2019-03-26):

power budget

hartytp, 2019-03-26:
one more thing: the power budget is not correct (e.g. wrong amplifier part number)

gkasprow, 2019-05-20:
updated.

Closed 2019-05-20.

Thread 26 (2019-03-26):

InAmp power

hartytp, 2019-03-26:
Currently, the InAmps are powered from the filtered (SMPS) P12V0A and NV12V0A lines. I'm a little worried that this will be problematic for the higher InAmp gain settings (smaller input signals).

What about adding P/N 11V5 rails for the InAmps (we may be able to use the existing P11V5 rail, but I'd be worried about leakage from the amplifier/DAC RF onto the supply rail getting rectified in OpAmps leading to DC offsets)?

For small common-mode voltages the AD8253 will still be able to hit +-10V at 11V5 supply, although it's more comfortable at 12V supplies.

gkasprow, 2019-04-16:
added dedicated LDOs for both rails

Closed 2019-04-16.

Thread 27 (2019-05-20):

panel design

gkasprow, 2019-05-20:
how should LEDs be marked on the panel?
Note that there is very little space for any marking.
One LED is green, the other is red, so maybe we don't need any marking :)
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

hartytp, 2019-05-20:
I’m fine with unlabelled leds if there is so little space. Something generic like “error” is unhelpful anyway

jordens, 2019-05-20:
Nothing for the LEDs. But in and out for the connectors and channel numbers is crucial.

jbqubit, 2020-01-17:
@marmeladapk What does panel design look like as produced?

jbqubit, 2020-01-17:
https://github.com/sinara-hw/Sayma_AMC/issues/121#issuecomment-575673522

Please post photo of what they look like with connectors installed. Helps us all be on the same page about what this looks like before they are ordered in larger number.

Thread 30 (2020-01-15):

Channel zero has lower amplitude

marmeladapk, 2020-01-15:
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

Yellow: SMA output from channel 0
Blue: SMA output from channel 1
Violet: Probe of channel 0
Green: Probe of channel 1

Channels were probed on R95, so before amplifier and after filter and balun. It seems that CH0 has higher amplitude initially, but then it gets distorted.

It's consistent on all basemods that we tried.

marmeladapk, 2020-01-15:
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

Measuring on DAC output, negative lines.

gkasprow, 2020-01-15:
Try it with lower frequency. Try to swap the scope probes between channels.

marmeladapk, 2020-01-15:
I'll try on sine generator from @sbourdeauducq, but I'll need to swap channels in JCDG.

marmeladapk, 2020-01-20:
Output from modified testmod (yellow, blue - dac ch0; pink, green - dac ch2), averaging from 32 triggers
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

I removed baluns and connected SMA directly to +- lines.

Differential signal Ch0:
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

Differential signal Ch2:
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

Waveforms compared (red: DAC channel 0 differential, white: DAC channel 2 differential)
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

So there's a slight difference, but nothing as drastic as we saw on Basemod. Those small differences could be due to solder joints, slightly longer cables which were used to connect pads etc. I'd say that the problem is on Basemod. Thoughts @gkasprow ?

Here's the same measurement on ARTIQ, all channels get sine wave, phase difference is due to gateware. Same situation.

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

sbourdeauducq, 2020-01-21:
> Here's the same measurement on ARTIQ (but 50 MHz instead of 240 MHz)

If you upgrade Vivado, you should be able to get 240MHz out of ARTIQ using SAWG. I was able to get SAWG sine output on my board.

marmeladapk, 2020-01-22:
Yellow: Channel0_N Blue: Channel0_P Pink: Channel1_N Green: Channel1_P, measured at TR1 pads (6 and 4)
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

gkasprow, 2020-01-22:
I looks loke asymetrically driven balun. Check if there is connection between dac and balun on both p and n wires.

Pozdrawiam,
G.Kasprowicz

________________________________
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

marmeladapk, 2020-01-22:
Channel 0 (averaging from 32 triggers) measured at capacitor pads (so directly from on DAC output with C37 and C46 removed)
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

gkasprow, 2020-01-22:
How it compares with other channels?

Pozdrawiam,
G.Kasprowicz

________________________________
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

marmeladapk, 2020-01-22:
This is asymetrically driven balun: only _N (yellow) is driven and _P (blue) is measured:
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

gkasprow, 2020-01-22:
this would explain the issue. maybe connector pad assignment is wrong?

marmeladapk, 2020-01-22:
@gkasprow In the previous screenshot I left one of capacitors unpopulated (on _P line).

marmeladapk, 2020-01-22:
I replaced C46 and C37, still _P line is weaker.

marmeladapk, 2020-01-22:
I removed R41 - jumper after balun on channel 0 so channel 0 is not loaded.
yellow blue - ch0; pink green - ch1 (not modified, for reference)
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

So the effect persists.

marmeladapk, 2020-01-22:
Thought for later: I can't see anything special about layer of channel 0. Since it's skewed on all boards that we tried perhaps PCB has some defect?

The effect seems to be caused by balun (currently its output is disconnected and signal from DAC looked fine when balun was disconnected). It's not caused by C37 and C46, I replaced them. Removing C44 didn't help. Maybe pads under balun have some resistive connection to something?

gkasprow, 2020-01-22:
We can check it with VNA tomorrow.

marmeladapk, 2020-01-28:
After amplifier:

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

marmeladapk, 2020-01-28:
Swapping amplifiers didn't change the situation, chan 0 is still distorted.

gkasprow, 2020-01-28:
But surprisingly, the signal from balun, routed to the SMA with a piece of the cable looks OK, it has the same amplitude on both channels.

Thread 31 (2020-03-31):

BaseMod Photos

jbqubit, 2020-03-31:
For accounting purposes please post high resolution photo of stuffed BaseMod front and back sides. Also post photo showing stuffed PCBs (one photo of array of boards is fine).

> BaseMod v2.0: print 20 PCBs, stuff 12

akaminska, 2020-04-07:
1907180PW0007A0108
1907180PW0007A0105
1907180PW0007A0109
1907180PW0007A0115
1907180PW0007A0113
1907180PW0007A0106
1907180PW0007A0110
1907180PW0007A0104
1907180PW0007A0107
1907180PW0007A0114
1907180PW0007A0111
1907180PW0007A0112
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

akaminska, 2020-04-07:
Unpopulated PCBs
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

jbqubit, 2020-04-07:
Thank you!

Closed 2020-04-07.

Thread 33 (2021-06-02):

S50 trace on L4 has wrong impedance

marmeladapk, 2021-06-02:
Its reference should be L2 and L5 (similarly to D100). It's a minor issue as adc signals aren't high speed + it's a small part of the signal.

Closed 2021-06-02.
