sinara-hw/BaseMod/(commit log)

2019-01-02 rev2.0rc1 sch review
    [ADC_4CH.SchDoc, BaseMod.PrjPCB, BaseMod.SchDoc, DAC_channel.SchDoc, Input_channel.SchDoc, Mgmt.SchDoc, PowerSupply.SchDoc, SEAx_connector.SchDoc]
2019-01-02 cosmetic updates
    [ADC_channel.SchDoc, B2B_connectors .SchDoc, BaseMod.PrjPCB, DAC_channel.SchDoc, FP_connectors.SchDoc, Input_channel.SchDoc, Mgmt.SchDoc, PowerSupply.SchDoc]
2019-04-15 80% routing done
    [BaseMod.SchDoc, DAC_channel.SchDoc, PowerSupply.SchDoc, SEAx_connector.SchDoc]
2019-04-17 v2.0rc2 pcb review
    [ADC_4CH.SchDoc, BaseMod.PrjPCB, BaseMod.SchDoc, DAC_channel.SchDoc, Input_channel.SchDoc, Mgmt.SchDoc, PowerSupply.SchDoc, SEAx_connector.SchDoc]
2021-06-02 Fixed #33
    [BaseMod.PrjPCB]
